dev-fred/GPS_Tracker_ESP8266/GPS_Tracker_ESP8266V1_WEB_FRSKY_OSD-DJI-OTA-ESP-01S/README.md

# GPS_Tracker_ESP8266V1_WEB_FRSKY_OSD-DJI-OTA-ESP-01S



Battit au-dessus de GPS_Tracker_ESP8266V1_WEB_FRSKY, cette version ajoute une sortie MSP vers une caméra 
DJI FPV Air Unit ou Caddx Vista, ce qui permet d'afficher dans l'OSD les infos provenant du GPS de la balise :
* La latitude, la longitude
* Le nombre de satellites (clignote tant que la position de départ n'est pas définie)
* La vitesse sol
* La direction du point de départ
* La distance au point de départ

La partie FRSKY, également connectée, envoie les données de télémesure à la radio.

### Carte
Ce projet, développé avec plastinaf, utilise la carte ESP8266-01S de [AZ-Delivery](https://www.az-delivery.de/fr/products/esp8266-01) qui se compile avec la carte Generic ESP8266

### Schéma

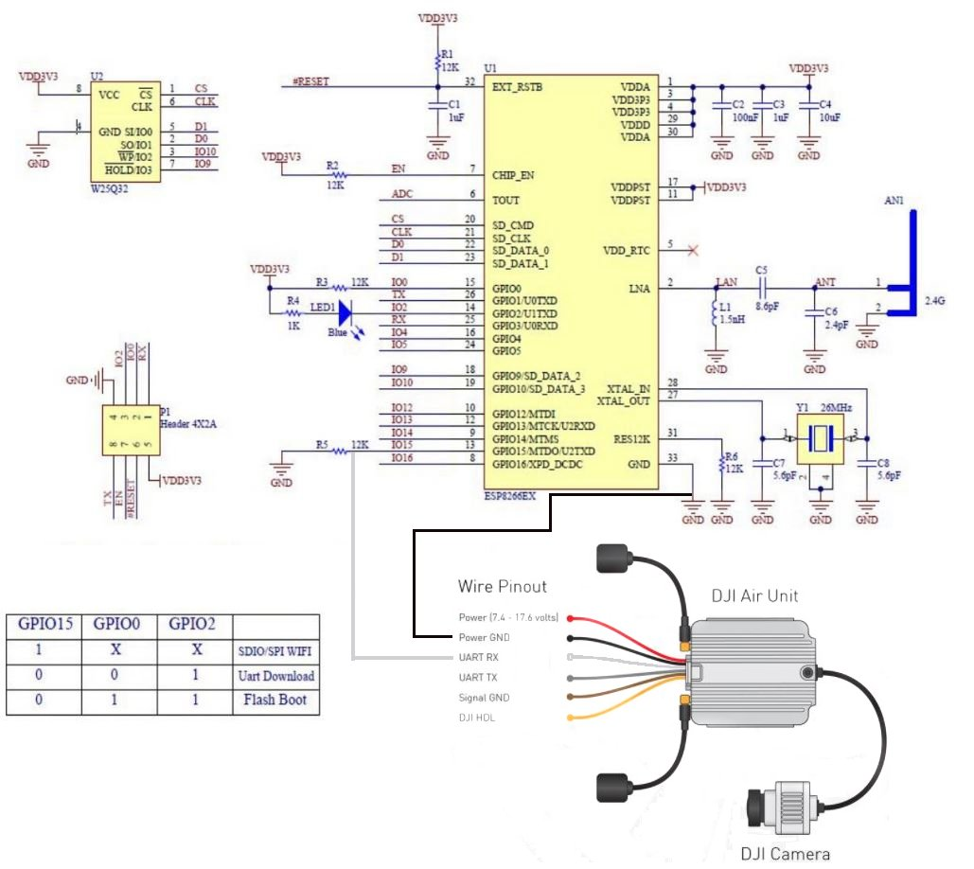
[picture p16: GPS_Tracker_ESP8266V1_WEB_FRSKY_OSD-DJI-OTA-ESP-01S/img/Esp8266ex.jpg]


### Câblage
Il est possible de cascader ce dispositif avec un module de télémétrie Frsky/Sport comme un Vario par exemple; dans ce cas il faut insérer une résistance de 1,5K entre la sortie GPIO3 du signal sport et le connecteur JST pour protéger la sortie de l'esp8266.

En mode fonctionnement CH_EN est relié à VCC

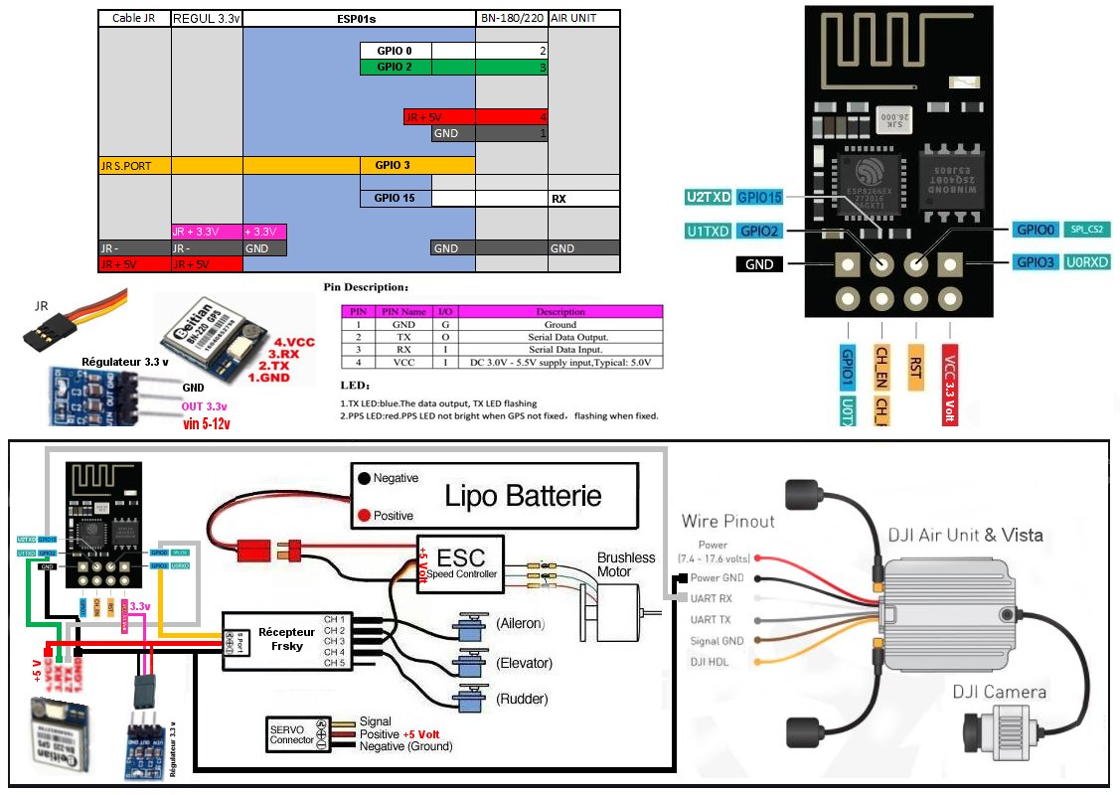
[picture p17: GPS_Tracker_ESP8266V1_WEB_FRSKY_OSD-DJI-OTA-ESP-01S/img/Description.jpg]


### GPIO15

* Récupération du port GPIO15
* CH_EN est relié à VCC
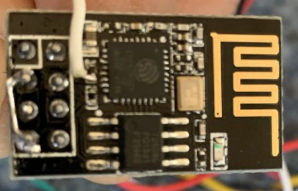
[picture p18: GPS_Tracker_ESP8266V1_WEB_FRSKY_OSD-DJI-OTA-ESP-01S/img/GPIO15.PNG]


### Configuration des positions

Editer l'onglet **OSD_positions_config.h**

* Dans le configurateur Betaflight, placez les éléments OSD aux positions souhaitées et, dans le CLI, tapez "set osd" pour récupérer les chiffres.
* La position **234** est non visible. 
* On peut aussi choisir directement la position en utilisant le tableau de  30 caractères X 16 lignes ( Horizontalement 2048-2077(espacement 1), 
verticalement 2048-2528(espacement 32)). La position **2254** correspond à l'emplacement par défaut de la croix.

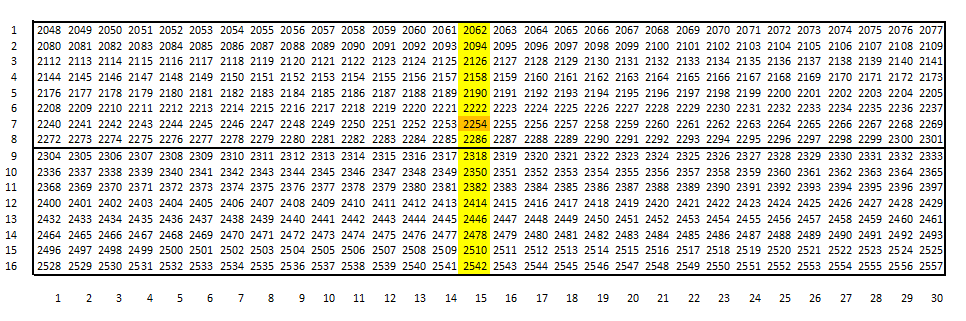
[picture p19: GPS_Tracker_ESP8266V1_WEB_FRSKY_OSD-DJI-OTA-ESP-01S/img/OSD_positions.png]
