dev-fred/GPS_Tracker_ESP8266/GPS_Tracker_ESP8266/README.md

Version obsolete, utiliser la V1 basée sur fichier droneID_FR.h de f5soh -> https://discuss.ardupilot.org/t/open-source-french-drone-identification/56904/98
