dev-fred/GPS_Tracker_ESP8266/GPS_Tracker_ESP8266V1/img/Balise_led.gif

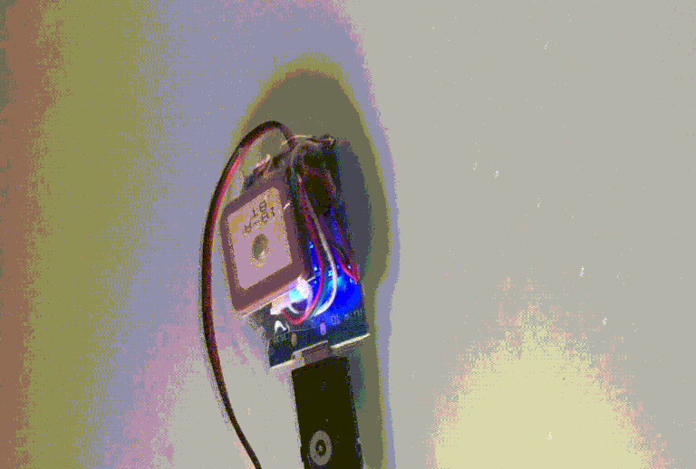
GPS_Tracker_ESP8266V1/img/Balise_led.gif
