dev-fred/GPS_Tracker_ESP8266/GPS_Tracker_ESP8266V1_MAP_FRSKY/img/Capture5.PNG

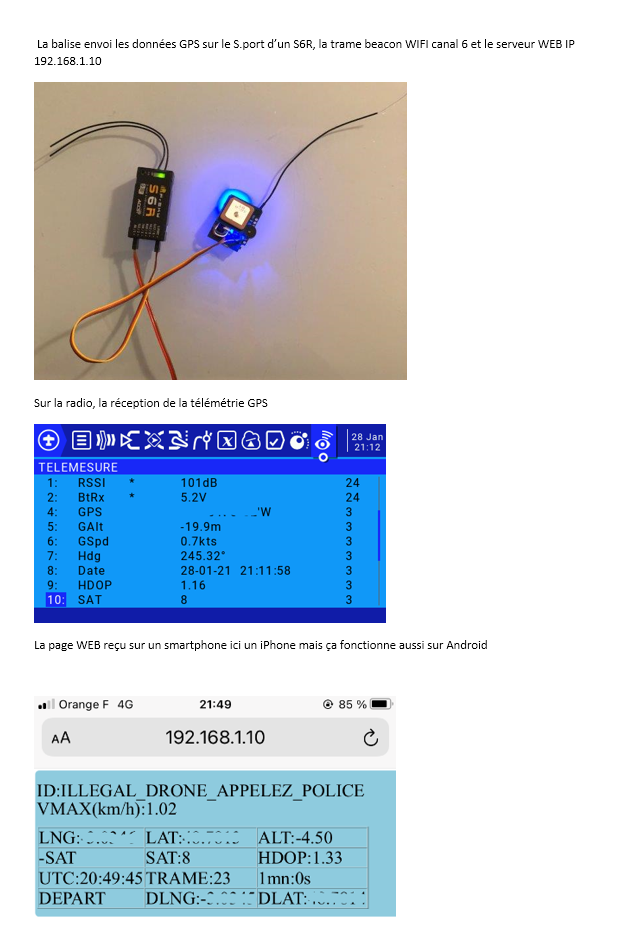
GPS_Tracker_ESP8266V1_MAP_FRSKY/img/Capture5.PNG
