dev-fred/GPS_Tracker_ESP8266/GPS_Tracker_ESP8266V1_MAP_FRSKY/img/screen-2021-02-01-194948.jpg

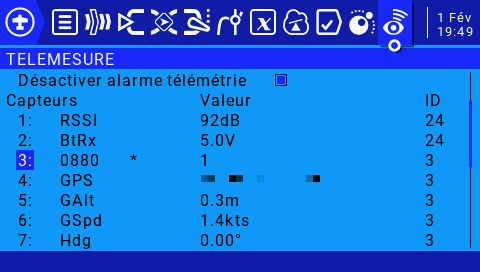
GPS_Tracker_ESP8266V1_MAP_FRSKY/img/screen-2021-02-01-194948.jpg
