dev-fred/GPS_Tracker_ESP8266/GPS_Tracker_ESP8266V1_MAP_FRSKY/img/screen-211200.bmp

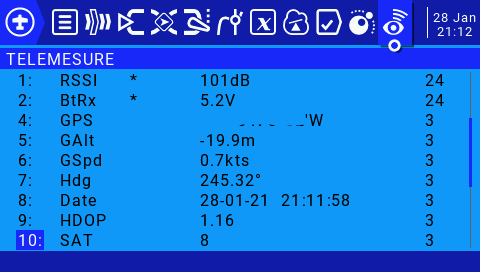
GPS_Tracker_ESP8266V1_MAP_FRSKY/img/screen-211200.bmp
