dev-fred/GPS_Tracker_ESP8266/GPS_UBX_CONF/img/Capture2.PNG

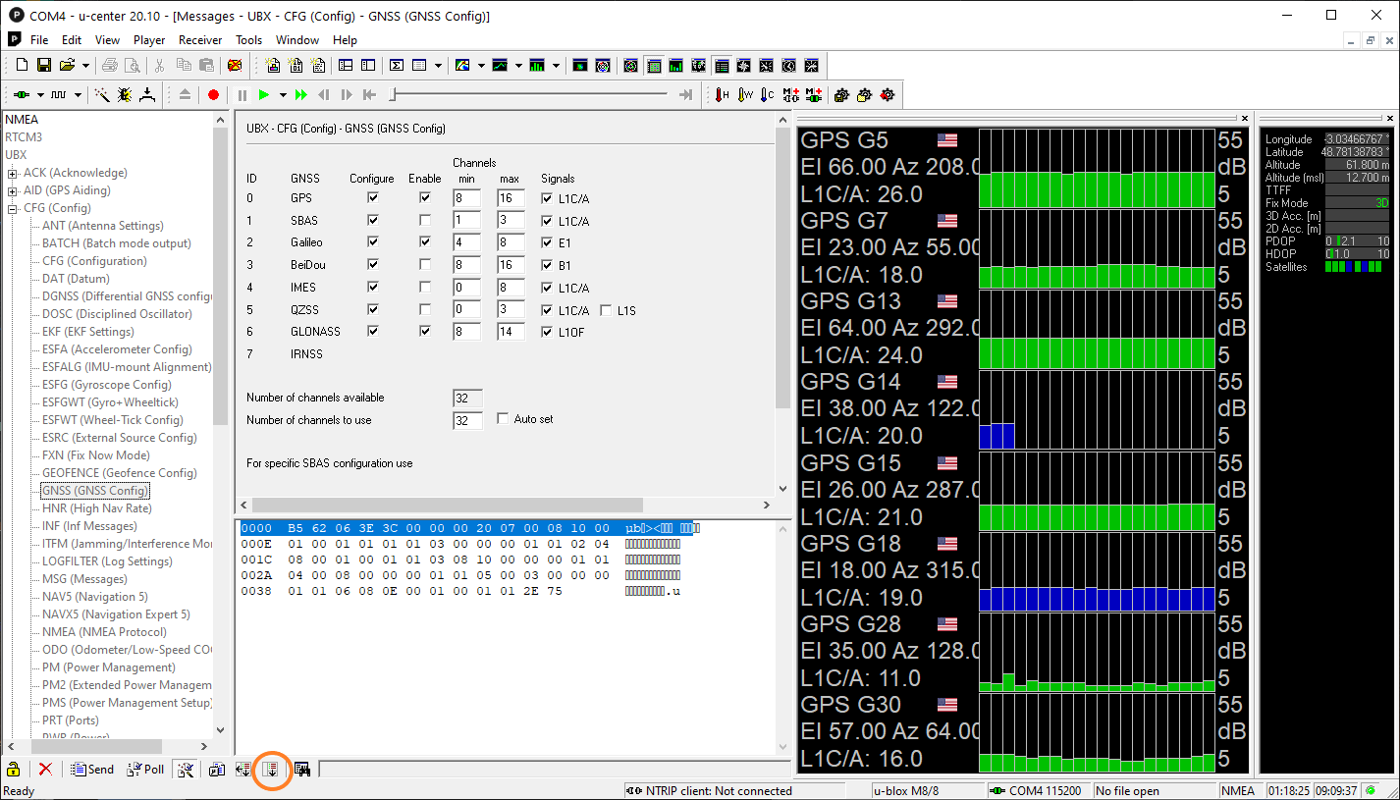
GPS_UBX_CONF/img/Capture2.PNG
