dev-fred/GPS_Tracker_ESP8266/(threads)

Thread 1 (2021-04-06):

SOFT_SERIAL_PIN_3 non defini sur FrSkySportSinglewireSerial.h

DJSpray, 2021-04-06:
dans le cas de l'utilisation d'un ESP01, le tutoriel demande de modifier les ports du RX et TX GPS (ok) mais aussi celui de la Telemetrie SPort.
Le port proposé (GPIO3) ne semble pas pouvoir etre appelé par le nom SOFT_SERIAL_PIN_3 car celui-ci est dit indefini dans la librairie FrSKySportSingleWireSerial.h (ce que je confirme, ligne 40 du fichier....).
est-il possible d'utiliser un autre port? faut-il ajouter la possibilité dans le fichier de la librairie?

DJSpray, 2021-04-06:
Merci,
J'avais effectivement fait cela de mon côté mais pas de détection de
télémétrie sur ma x12... Je me suis dis que cela n'était peut être pas si
"simple".
Je vais me pencher un peu plus, sinon tester et monter sur un d1mini que
j'ai aussi dans le tiroir (mais plus gros et donc pas adapté à nombreux de
mes modèles).
Merci de la réponse rapide!

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

dev-fred, 2021-04-06:
Je viens d'avoir la confirmation que cela fonctionne avec cette modification sur un ESP01S, il avait juste oublié de me communiquer cette modif de librairie. Autre précision, Flash size: "1MS(FS:none OTA:~502KB)"

dev-fred, 2021-04-07:
Autre précision, PIN 3 correspond à GPIO3 qui est aussi libellé RX en face de VCC

DJSpray, 2021-04-07:
oui oui.
le SPort sur le RX peut avoir juste le simple cable "signal" branché? pas
de pb le fait que mon ESP01 soit en 1S et mon RX en 2S (le signal n'est
donc pas forcement sur les meme niveaux de crete j'imagine?)

Le mer. 7 avr. 2021 à 07:45, dev-fred ***@***.***> a écrit :

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

dev-fred, 2021-04-07:
Oui, des 2 cotés l’électronique des ports est en 3.3V

DJSpray, 2021-04-07:
bon, je dois avoir un autre soucis.
jamais utilisé de telemetrie donc c'est nouveau pour moi dans OpenTX...
je viens d'essayer sur un autre recepteur (un X6R au lieu d(un x8R... donc
pas si differents.... :)
toujours que le RSSI et bat detectés en telemetrie.
j'ai ensuite pris mon d1mini et poussé la config par defaut histoire
d'ecarter la piste de l'ESP01... idem!
tu saurai me dire pourquoi j'ai ca?
je suis en mode D16 classique, et je raccorde donc juste le port SPort (D8
donc sur le D1mini) sur le fils "signal" du port SPort coté RX (donc la pin
le plus a l'exterieur du RX coté antenne de mon X6R).

desolé de te deranger encore, j'espere trouver la solution car c'est tout
de meme pratique comme fonction pour retrouver son modele!

Le mer. 7 avr. 2021 à 11:51, dev-fred ***@***.***> a écrit :

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

DJSpray, 2021-04-08:
ok, resolu......
il parait qu'une tension est une difference de potentiel entre deux points (d'apres mes souvenirs de colleges....). brancher que le cable signal sans meme une masse commune entre mon RX et l'ESP ne peut donc pas fonctionner.
erreur de noob.
J'ai alimenté mon D1mini par l'usb de mon PC, puis renvoyé le 5V (VCC) et la masse sur les deux autres fils pour l'alimentation de mon recepteur. et magie, cela marche du premier coup!

merci encore pour ton super travail. je n'ai plus qu'a faire de meme sur mon ESP01 mais vraiment chapeau pour ton dev.

Closed 2021-04-08.

Thread 2 (2021-05-28):

connection défaillante au HotSpot WiFi

cavern-man, 2021-05-28:
Avec le GPS_Tracker_ESP8266V1_WEB le HotSpot créé émet correctement mais ne délivre pas d'adresse IP au client. Dès lors, impossible de se connecter depuis un téléphone.

Depuis un ordinateur la connexion WiFi est possible mais l'adresse 192.168.1.10 ne peut être résolue.

dev-fred, 2021-05-29:
Il faut faire un scan du réseau, il devrait apparaitre dans la liste avec un nom de la forme  SSID+MAC ADDRESS  soit par exemple BALISE_E8_DB_84_DA_82_AD, se connecter dessus, puis ouvrir un navigateur sur l'adresse IP 192.168.1.10

cavern-man, 2021-05-29:
Bonjour et merci de cette réponse rapide.

Le réseau est bien visible, mais le hot spot ne delivre pas d'adresse IP.

Avec le même matériel, le code exemple pour un hotspot proposé par l'IDE Arduino fonctionne.

Cordialement.

29 mai 2021 09:14:33 dev-fred ***@***.***>:

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

dev-fred, 2021-05-29:
Cela fonctionne sans problème sous ios et android, je viens de retester, il y a juste des messages qui indiquent que le réseau n'est pas sécurisé. Cette appli n'est pas nouvelle et je ne vois pas comment vous aider, désolé

cavern-man, 2021-05-29:
Merci d'avoir essayé. Je vais tenter en déversant peu à peu le code dans l'exemple de hotspot de l'IDE

29 mai 2021 20:35:02 dev-fred ***@***.***>:

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

cavern-man, 2021-06-02:
Bonsoir,
J'ai bien avancé. En déversant le code petit à petit, j'ai obtenu des résultats trop instables.
Du coup, je suis reparti de zéro, avec une fresh install de l'IDE sur Linux, un chargement des bibliothèques en prenant toujours une version en dessus de la dernière.
Le résultat est bine plus probant, et votre code permet une connexion rapide et systématique au WiFi. j'ai fait une version WEB et une version MAP avec le même succès... relatif.
En effet, le GPS semble bien faire le fix d'après ses leds, mais rien ne remonte sur le serveur web. J'utilise des ESP01, la déclaration des broches est-elle à ajuster dans le code ?
Je vais fouiller les forum mais n'ai pas encore trouvé la réponse.
bien sincèrement.  /Emmanuel.

    Le samedi 29 mai 2021 à 22:55:24 UTC+2, Emmanuel ELIE ***@***.***> a écrit :

  Merci d'avoir essayé. Je vais tenter en déversant peu à peu le code dans l'exemple de hotspot de l'IDE

29 mai 2021 20:35:02 dev-fred ***@***.***>:

Cela fonctionne sans problème sous ios et android, je viens de retester, il y a juste des messages qui indiquent que le réseau n'est pas sécurisé. Cette appli n'est pas nouvelle et je ne vois pas comment vous aider, désolé

—
You are receiving this because you authored the thread.
Reply to this email directly, view it on GitHub, or unsubscribe.

cavern-man, 2021-06-03:
Trouvé !
mauvaise déclaration des pin de communication avec le GPS pour ESP01 voici la modification :
#define GPS_RX_PIN 0            // pour ESP01 fil Tx du GPS
#define GPS_TX_PIN 4            // pour ESP01, non utilisé
// #define GPS_RX_PIN 5            // D1 Brancher le fil Tx du GPS
// #define GPS_TX_PIN 4            // D2 Brancher le fil Rx du GPS

Closed 2021-06-03.

Thread 3 (2021-09-10):

Soucis de fonctionnement

vertigo475, 2021-09-10:
Bonjour,
Avant tout merci pour votre partage.
J'essaie de faire fonctionner mon d1 mini avec GPS 22o V1 WEB.
J'ai observé le shéma de connexion et ajouté les librairies me semblant nécessaires (je suis débutant en arduino et je n'ai pas bien compris les éléments des diverses librairies).

A priori j'ai la led bleue du D1 mini qui reste solide et le GPS clignote bleu seulement. de plus je n'arrive pas à me connecter avec mon portable. je vois le wifi, je peux me connecter mais le 192.168.1.10 ne me donne rien, ça mouline.

J'ai aussi une erreur de librairie TinyGPS++ on me dit "la bibliothèque TinyGPSPLUS prétend être exécutable sur la (ou les) architecture(s) esp32 et peut être incompatible avec votre carte actuelle qui s'exécute sur esp826...

Existe-t-une version de code, prêt à implanter dans le D1mini y compris tout les paramètres nécessaire et diverses librairies requises ?

D'avance merci de votre retour et bonne journée
Olivier

vertigo475, 2021-09-13:
Bonjour,
J'ai trouvé le pourquoi du comment.
Dans le shéma de branchement le fil blanc du GPS doit aller sur le GPIO0 sur D3 + la modification du code dans les "issues" par cavern-man, merci à lui. et ça marche !

Merci encore à Dev Fred pour ce projet.

dev-fred, 2021-09-15:
Le warning "library TinyGPSPLUS claims to run on esp32 architecture ..." provient de ce que vous avez sans doute utilisé la bibliothèque TinyGPSPLUS  au lieu de TinyGPS++. Cette bibliothèque est une version intermédiaire entre TinyGPS et TinyGPSPLUS  qui s'installe manuellement et c'est expliqué ici :  http://arduiniana.org/libraries/tinygpsplus/
Par curiosité j'ai installé depuis le gestionnaire de librairie TinyGPSPLUS et renommé #include <TinyGPS++.h> en #include <TinyGPSPLUS.h>, à la compilation j'ai le fameux warning et cependant mon GPS connecté sur GPIO5-RX et GPIO4-TX fonctionne sur mon D1 mini de chez AZ-Delivery aussi je ne reproduis pas votre problème alors que j'utilise GPIO5. Ceci dit les GPIO sont interchangeables et ce n'est pas 1 problème en soi. Pour finir il est possible que l'utilisation de TinyGPSPLUS, installé directement depuis le gestionnaire de librairie ne pose aucun problème sur les esp8266 mais je n'ai rien trouvé de convaincant sur le net et donc je reste conservateur aussi j'ai documenté les codes:
 `//installer manuellement http://arduiniana.org/libraries/tinygpsplus/`
`#include <TinyGPS++.h>`

vertigo475, 2021-09-15:
Bonjour merci beaucoup pour ces explications. C'est parfait ! J'avais pu résoudre le problème et ferme la issue. En utilisant le gpio0 selon commentaires deja postes. J'ai testé le système et cela semble fonctionner parfaitement. Merci beaucoup et bonne journée . Olivier

Téléchargez Outlook pour iOS<https://aka.ms/o0ukef>
________________________________
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

dev-fred, 2021-09-15:
Ravi que vous ayez résolu votre problème, de mon coté j'essaye juste de comprendre le pb que vous avez eu. Dans le cas d'1 esp01 GPIO5 n'est pas disponible aussi GPIO0 est un choix possible. C'est ce que j'utilise dans ce projet : https://github.com/dev-fred/GPS_Tracker_ESP8266/blob/main/GPS_Tracker_ESP8266V1_WEB_FRSKY_OTA/img/Description.jpg

vertigo475, 2021-09-15:
Merci pour toutes ces précisions et d'avoir partagé votre projet.

Je découvre petit à petit l'univers "arduino" je trouve cela passionnant.

Bonne journée et salutations
Olivier

Téléchargez Outlook pour iOS<https://aka.ms/o0ukef>
________________________________
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

vertigo475, 2021-09-18:
Bonjour,

J'ai fait quelques test en vol (avion mot electrique) avec le ESP01 V1D.

Si je suis connecté en wifi sur la balise via le smartphone. Je reçois les points gps et les indications seulement lorsque je suis à quelques mètres de la balise. Des que je prends de l'altitude ou que je m'éloigne, le système n'enregistre plus les points GPS. De retour au sol je charge le GPX ou je l'affiche et je vois le moment ou le système a décroché au mieux à une trentaine de mètres au maximum. J'ai le sentiment que les points ne sont enregistrés dans la balise que lorsque la balise est connectée au gps. Est-ce juste ? Est-il possible de retirer les enregistrements de vols dans l'arduino ?

Désolé de vous ennuyer encore, j'adore votre projet et j'aimerais vois jusqu'où on peut l'emmener.

Bonne soirée et meilleures salutations
Olivier

Téléchargez Outlook pour iOS<https://aka.ms/o0ukef>
________________________________
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

dev-fred, 2021-09-19:
Si vous utilisez le projet GPS_Tracker_ESP8266V1_MAP, j'ai fait une mise en garde en bas de la page https://github.com/dev-fred/GPS_Tracker_ESP8266 :

Projet déconseillé, il ne tient pas ses promesses; la portée de la balise et la fréquence d'échantillonnage des positions GPS sont très insuffisantes.

Je vais ajouter cette mise ne garde sur la page du projet

vertigo475, 2021-09-19:
Bonjour,

Encore une fois merci pour votre réponse. Ce n'est pas mon utilisation qui est en cause.

Je vais chercher encore un/des projets correspondant davantage à l'application modèles réduits.

Si vous avez des idées je suis preneur, mais ne perdez pas de temps pour moi.

Bonne journée et meilleures salutations.
Olivier

Téléchargez Outlook pour iOS<https://aka.ms/o0ukef>
________________________________
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

Closed 2021-09-13.

Thread 4 (2022-04-16):

Manque un bout de code concernant le SSID

PascalRZ, 2022-04-16:
Bonjour,
Après plusieurs tentatives avec les différents fichiers ino pour ESP8266, pas de fonctionnement de la balise (en fait 6 balises avec des D1 mini et D1 mini pro) avec certains d'entre eux, les SSID détectés par mon smartphone étant du type "ESP-xxxx" ou "MicroPython-xxxxxx". Il manque un bout de code dans les versions "non-WEB" que j'ai ajouté ci-dessous en m'inspirant des versions WEB qui m'ont mis la puce à l'oreille car elles fonctionnent et "figent" le SSID suite à la création de l'Access Point même si on reflashe avec une version "non-WEB". La modification qui rend la balise fonctionnelle :

 // start WiFi
  WiFi.mode(WIFI_OFF);

  //conversion de l'adresse mac:
  String temp = WiFi.macAddress();
  temp.replace(":","_");
  //concat du prefixe et de l'adresse mac
  temp = String(prefixe_ssid) + "_" + temp;
  //transfert dans la variable globale ssid
  temp.toCharArray(ssid, 32);

  // set default AP settings
  WiFi.softAP(ssid, nullptr, 6, false, 0); // ssid, pwd, channel, hidden, max_cnx,
  WiFi.setOutputPower(20.5); // max 20.5dBm

Pouvez-vous corriger les fichiers (je ne sais pas me servir de Github pour cela, je ne suis pas informaticien, je sais juste survoler des bouts de codes) ?

dev-fred, 2022-04-18:
Bien que je ne sois pas sûr de comprendre en quoi, la détection du SSID par votre smartphone, des balises utilisées en mode non WEB, peut poser un problème puisque l'on n'utilise pas de smartphone dans ce cas là, il y a un manque de cohérence avec GPS_Tracker_ESP8266V1/GPS_Tracker_ESP8266V1.ino et GPS_Tracker_ESP8266V1/GPS_Tracker_ESP8266V1.ino dans la façon de créer le SSID que je corrige.

Closed 2022-04-20.

Thread 5 (2023-03-05):

Ajout du programme à un "companion computer" de type raspberryPi

brocciu, 2023-03-05:
Merci pour votre travail.
Pensez-vous qu'il soit possible d'ajouter ce programme à un raspberryPi connecté a un contrôleur de vol (par MAVLink via les port rx/tx) ?
Cela permettrait de l'ajouter en parallèle de programme comme "Rpanion" ou "openHD".

dev-fred, 2023-03-06:
Le projet produit du code machine généré par l'environnement Arduino, depuis Windows dans mon cas, directement exécutable sur des microcontrôleurs. Le Raspberry Pi est un ordinateur qui s'appui sur le système Linux qui peut faire tourner différents logiciels dont Arduino, Rpanion ...
Voir https://www.selectronic.fr/informatique/arduino-ou-raspberry-pi/
Evidement il n'y a rien d'infaisable, mais à ma connaissance, ce code source n'est pas utilisable directement pour faire tourner un programme dans l'environnement Linux.

Thread 6 (2023-03-08):

comment implanter le code ?

fabytroll, 2023-03-08:
Bonjour,
j'ai fait les soudures etc des différents modules. En revanche comment faire le transfert du code vers la carte wifi depuis Windows ?
Lorsque l'on branche le cable usb sur la carte rien ne se passe.
Merci
