dev-fred/GPS_Tracker_ESP8266/(commit log)

2021-04-14 Add Altitude, Craft Name, Tension de la batterie avec alarme
2021-04-18 add blink Batterie < 3.6V et cell télémétrie
2023-06-16 Update GPS_Tracker_ESP8266V1_WEB_FRSKY_OSD-DJI-AIR-UNIT.ino
    Connexion automatique sur la balise
2023-07-16 Update README.md
    Résistance de protection 1,5K
