dev-fred/GPS_Tracker_ESP8266/(notices)

Notices in the files:
GPS_Tracker_ESP8266V1_WEB_FRSKY_OSD-DJI-AIR-UNIT/GPS_Tracker_ESP8266V1_WEB_FRSKY_OSD-DJI-AIR-UNIT.ino:
This program is free software: you can redistribute it and/or modify
it under the terms of the GNU General Public License as published by
the Free Software Foundation, either version 3 of the License, or
(at your option) any later version.
